JordonLong/Team03-TelemetryModule/README.md

# Team03-TelemetryModule
ELEC5551 Design Group 3 Telemetry Module Files

Please find the design outputs folder in this repository for UWA ELEC5551 Team03's telemetry System design
