JordonLong/Team03-TelemetryModule/06. Design Outputs/03. Documents/Team03 - Power Budget - V1 - 20240330.xlsx

Power-saving mode
 | Hour |  |  |  |  |  |  |  |  |  |  |  |  |  |  |  |  |  |  |  |  |  |  |  | RF Module Current Specification
 | 1 | 2 | 3 | 4 | 5 | 6 | 7 | 8 | 9 | 10 | 11 | 12 | 13 | 14 | 15 | 16 | 17 | 18 | 19 | 20 | 21 | 22 | 23 | 24
Component |  |  |  |  |  |  |  |  |  |  |  |  |  |  |  |  |  |  |  |  |  |  |  |  | Transmit current (mA) | 215
GPS | 25.00 | 0.42 | 0.42 | 0.42 | 0.42 | 0.42 | 0.42 | 0.42 | 0.42 | 0.42 | 0.42 | 0.42 | 0.42 | 0.42 | 0.42 | 0.42 | 0.42 | 0.42 | 0.42 | 0.42 | 0.42 | 0.42 | 0.42 | 0.42 | Sleep mode current (mA) | 0.0025
RF Module | 109.29 | 3.59 | 3.59 | 3.59 | 3.59 | 3.59 | 3.59 | 3.59 | 3.59 | 3.59 | 3.59 | 3.59 | 3.59 | 3.59 | 3.59 | 3.59 | 3.59 | 3.59 | 3.59 | 3.59 | 3.59 | 3.59 | 3.59 | 3.59 | Sleep time (second) | 59
Microcontroller | 0.02 | 0.02 | 0.02 | 0.02 | 0.02 | 0.02 | 0.02 | 0.02 | 0.02 | 0.02 | 0.02 | 0.02 | 0.02 | 0.02 | 0.02 | 0.02 | 0.02 | 0.02 | 0.02 | 0.02 | 0.02 | 0.02 | 0.02 | 0.02 | Wake time (second) | 1
Internal ICs of PSU | 20.00 | 20.00 | 20.00 | 20.00 | 20.00 | 20.00 | 20.00 | 20.00 | 20.00 | 20.00 | 20.00 | 20.00 | 20.00 | 20.00 | 20.00 | 20.00 | 20.00 | 20.00 | 20.00 | 20.00 | 20.00 | 20.00 | 20.00 | 20.00
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
