JordonLong/Team03-TelemetryModule/06. Design Outputs/01. Altium Files/00. Payload Transceiver/00. Main PCB Files/Report Board Stack/TelemetrySystem.xls

Board Stack Report
Stack Up |  | Layer Stack
Layer | Board Layer Stack | Name | Material | Thickness | Constant
1 |  | Top Paste
2 |  | Top Overlay
3 |  | Top Solder | Solder Resist | 0.010mm | 3.5
4 |  | Top Layer | Copper | 0.036mm
5 |  | Dielectric 6 | PP-006 | 0.071mm | 4.1
6 |  | +3.3V Plane | Copper | 0.035mm
7 |  | Dielectric 1 | FR-4 | 0.320mm | 4.8
8 |  | EW2 | Copper | 0.035mm
9 |  | Dielectric 4 | PP-006 | 0.071mm | 4.1
10 |  | +1.2V Plane | Copper | 0.035mm
11 |  | Dielectric 2 | PP-006 | 0.071mm | 4.1
12 |  | GND Plane | Copper | 0.035mm
13 |  | Dielectric 3 | PP-006 | 0.071mm | 4.1
14 |  | EW1 | Copper | 0.035mm
15 |  | Dielectric 5 | PP-006 | 0.071mm | 4.1
16 |  | Bottom Layer | Copper | 0.036mm
17 |  | Bottom Solder | Solder Resist | 0.010mm | 3.5
18 |  | Bottom Overlay
19 |  | Bottom Paste
 | Height : 0.942mm
