JordonLong/Team03-TelemetryModule/06. Design Outputs/01. Altium Files/01. Base Station Transceiver/01. Base Station Manufacturing Files/Report Board Stack/BaseStation.xls

Board Stack Report
Stack Up |  | Layer Stack
Layer | Board Layer Stack | Name | Material | Thickness | Constant
1 |  | Top Paste
2 |  | Top Overlay
3 |  | Top Solder | Solder Resist | 0.40mil | 3.5
4 |  | Top Layer | Copper | 1.40mil
5 |  | Dielectric 2 | PP-006 | 2.80mil | 4.1
6 |  | Ground | Copper | 1.38mil
7 |  | Dielectric 1 | FR-4 | 12.60mil | 4.8
8 |  | Bottom Layer | Copper | 1.40mil
9 |  | Bottom Solder | Solder Resist | 0.40mil | 3.5
10 |  | Bottom Overlay
11 |  | Bottom Paste
 | Height : 20.38mil
