JordonLong/Team03-TelemetryModule/06. Design Outputs/03. Documents/Team03 - NTC Temperature Sensor Conversion Graph - V1 - 20240514.xlsx

Constants |  |  | T ( Kelvin) | T (ºC) | Steinhart-Hart Equation (Ω)
 |  |  | 253.15 | -20 | 84.271
R0 (Ω) | β at 25ºC | T0 (Kelvin) | 257.15 | -16 | 67.651
10000 | 3575 | 298.15 | 261.15 | -12 | 54.676
 |  |  | 265.15 | -8 | 44.474
 |  |  | 269.15 | -4 | 36.399
 |  |  | 273.15 | 0 | 29.965
 |  |  | 277.15 | 4 | 24.807
 |  |  | 281.15 | 8 | 20.648
 |  |  | 285.15 | 12 | 17.275
 |  |  | 289.15 | 16 | 14.524
 |  |  | 293.15 | 20 | 12.269
 |  |  | 297.15 | 24 | 10.412
 |  |  | 301.15 | 28 | 8.874
 |  |  | 305.15 | 32 | 7.595
 |  |  | 309.15 | 36 | 6.527
 |  |  | 313.15 | 40 | 5.631
 |  |  | 317.15 | 44 | 4.876
 |  |  | 321.15 | 48 | 4.237
 |  |  | 325.15 | 52 | 3.695
 |  |  | 329.15 | 56 | 3.233
 |  |  | 333.15 | 60 | 2.837
 |  |  | 337.15 | 64 | 2.498
 |  |  | 341.15 | 68 | 2.206
 |  |  | 345.15 | 72 | 1.954
 |  |  | 349.15 | 76 | 1.735
 |  |  | 353.15 | 80 | 1.545
 |  |  | 357.15 | 84 | 1.380
 |  |  | 361.15 | 88 | 1.235
 |  |  | 365.15 | 92 | 1.108
 |  |  | 369.15 | 96 | 0.996
