JordonLong/Team03-TelemetryModule/06. Design Outputs/03. Documents/Team_3 Requirements Review.xlsx

ID | Requirement Title | Requirement description | Test | Passed | Learnings
RQ1 | Protection system | Suitable voltage regulators/converters need to be used to supply stable and correct voltages to individual components/subassemblies. | Simulations were conducted on both Simulink and LT Spice to validate the effectiveness of the design. Power simulations were conducted for the GPS, XBee and boost converter modules. | YES | The client was not specific about load requirements, giving the project team flexibility in how to approach the issue. Simulations provided a fundamental understanding of how the system will respond under both transient and steady state conditions.
RQ2 | Compliance | Quality components are compliance tested according to suitable standards or certificates identified by Team03. | All components were sourced through established licensed suppliers who conduct product testing. More so, each component was chosen only if its datasheet specified conditions such as RoHS compliance. | YES | Choosing components from professional vendors saves a significant amount of time compared to choosing un-professional vendors whose products require re-choosing more often.
RQ3 | Unlicensed frequency | Transmitters/receivers must use unlicensed frequency as part of the Low Interference Potential Devices (LIPD) class license. This entails operating within a range of frequencies, at maximum power and complying with other limitations stated in the license class. | The chosen XBee and GPS modules do not require the use of licensed frequencies. XBee module maximum power is below the allowable limit. | YES | There are a considerable number of Australian standards and laws related to operating radio equipment. Adhering to these laws and standards is essential for a legal and safe radio-based system.
RQ4 | Temperature | Telemetry system’s maximum operating temperature must be above 60°C. | All individual components were selected under the condition that their maximum operating temperature was above 60°C. Thermal testing was also conducted under various conditions to validate the design solution. | YES | The thermal simulation revealed that components approach their maximum operating temperature much more quickly than anticipated and thus require maximum operating temperatures to be as high as possible.
RQ5 | Thermal management | Provide heat dissipating mechanisms and select energy-efficient devices that minimise lost energy due to heat. | A thermal simulation was performed to evaluate the effectiveness of the designed payload transceiver PCB regarding thermal management. Considerations such as PCB thickness, component placement, power dissipation and maximum operating temperature were considered. | YES | Placement of components which generate significant heat must be separated. Smaller components with higher current draws often emit the most thermal energy.
RQ6 | Telemetry logging | Continuous interface with the drone’s sensors, logging telemetry data which can be later easily reviewed and downloaded. | RS232 and RS485 compatible ports have been included and connected to the payload transceiver such that their data can be stored on the onboard micro-SD card or transmitted via the radio module. | YES | Communications protocols often require more than simply connecting the ports to GPIOs of the microcontroller. They may have specific voltage level requirements and even work with negative voltages. Thus, additional components such as dedicated transceivers are necessary to ensure optimal communications.
RQ7 | Battery management system | The power supply will have battery health monitoring capability. The power supply will have battery charging capability. | Temperature monitoring sensors have been integrated into the design along with a fuel gauge to track the battery’s health. | YES | Temperature sensors come in several different types and choosing a particular model requires knowledge of the expected operating conditions and a compromise between accuracy and robustness.
RQ8 | Triangulation | Module needs to have radio triangulation capability that works if GPS hits a dead zone or activated for recovery upon landing. | Both triangulation and trilateration were implemented in conjunction with 3 base stations to ensure efficient tracking capabilities. | YES | Clear communication ensured that team 3 and the client were on the same page. In order to implement radio triangulation within the final design. Incorporating three base stations ensured this project requirement is achieved.
RQ9 | Sensor integration | The chosen microcontroller must have the ability to interact with RS232 and RS485 ports . | Any microcontroller with a UART port can interact with RS232 and RS485 ports provided that the necessary transceivers are implemented as well. | YES | Level shifters were required to integrate this as the RS232 and RS485 ports work in both negative and positive voltages, while the controller only functions on positive voltage. This required research into level shifters as well as the correct circuit connectivity and the appropriate component selection.
RQ10 | Data storage | The data for the whole flight should be stored in the memory. It can be cleared after recovery. | An SD card was integrated with the microcontroller to ensure adequate backup data storage within the drone. All data was also transmitted to the base station during nominal flight conditions. Functional control of the system was developed through the pseudo code of the design. | YES | The importance of redundancy features were clearly communicated by the client and incorporated into the design. This was achieved by selectively choosing components which are well established and proven. This methodology provides a reliable solution for the design’s redundancy features.
 |  | Remember the last few positions so that they can be re-transmitted if the previous packet get lost.
RQ11 | Long operation | Module needs to be able to run for at least 24 hours on standalone battery power | The batteries were appropriately sized based off an energy budget which analysed the energy consumption of the drone at all stages of operation | YES | Basing the energy consumption on the individual components while accounting for worst case energy usage ensuring that even under high loads the design can sustain operation for 24 hours. This in conjunction with redundancy features within the software to shutdown accessory loads ensure the payload can be located.
RQ12 | Control Unit | The microcontroller will be 32bit at the minimum . | Chosen microcontroller STM32u545 is 32 bits. | YES | Controllers with smaller bus lengths were incapable of providing the necessary processing power and high performance.
RQ13 | GPS accuracy | Module needs to have GPS tracking capability with at least <3m accuracy in three dimensions. | The GPS module is accurate to 2.5m according to the datasheet. However, based on triangulation calculations the altitude measurement has a margin of error of | NO | The GPS can provide accuracy levels for its longitude and latitude to the required specifications based off the datasheet. However, team 3 and the client were conflicted about the possible error margin for altitude calculations, further discussions may be required. Especially given the speed and altitude of the rocket. Making this requirement a significant challenge.
 |  |  | 4.592m.
RQ14 | Communication range | Telemetry transceiver must be able to transmit within 10km radius. | The telemetry module uses a monopole antenna with sufficient gain required by XBee datasheet (Table 10) to achieve operating range over 10km. | YES | Lack of prebuilt XBee models in the literature to simulate the transmitter, channel and receiver. Operating range is confirmed via product datasheet, however, verification could not be achieved without physical components.
RQ15 | Data transmission | Transmission rate must be at least 5kbit/s. | The chosen radio communication module can provide 10kbits/s data rate according to Table 10. | YES | Similar to RQ14, due to the lack of simulation resources, requirement could not be physically verified. However, datasheet indicates twice the required data rate which provides safe clearance from the minimum rate.
 |  | PCBs will be designed for high-speed operation and strong signal integrity .
RQ16 | Radio triangulation accuracy | Can be activated within 10-20m and omnidirectional . | Using information from the antenna and radio module datasheets it was summised that the telemetry system can achieve a 10m-20m activation from any direction. | YES | The monopole antenna is omnidirectional as specified by its datasheet, thus allowing for radio communications to be sent and received from any direction. To achieve 10m-20m activation, the specific Xbee radio module was chosen such that it has a variable transmission range down to at least 10m if required.
RQ17 | Redundancy | Module must have built in redundancy to ensure continuous operation in the event of failures in internal / interconnected systems. | The GPS module and SD card have inbuild data storage. The code also has inbuild failsafe methods to ensure the drone can operate independently. When communication from the base station fails | YES | Redundancy features were implemented through a multi-layered data storage which can act independently from each other during emergencies. By relying on multiple components with different functions such as the Base station, GPS and SD card. The design can ensure flight data can be recovered.
RQ18 | Robust to withstand impact | Each individual component should be rated to withstand at least 8m/s impact. | No specific tests were applied due to the lack of proper impact simulation software. Additionally, no datasheets of individual components offered any impact ratings / data. | NO | The acquisition of dedicated stress / impact testing software would be beneficial in providing the client with a specific estimate of the telemetry system’s impact resistance.
RQ19 | User-interface | Develop a limited user interface for the base station's operation. | UI was developed and visualized to provide key telemetry data which requested by the client during flight. | YES | The importance of selecting a component that has an existing proprietary user interface alongside a dedicated test and configuration suite. This allows for robust configuration of parameters and testing through a dedicated software suite. The client had no requirement for a custom interface and was satisfied with a proprietary manufacture interface.
RQ20 | Mounting | PCBs must provide adequate mounting points (with clearance) to ensure easy installation within the payload. | Four M3 mounting holes have been incorporated into each corner of the payload transceiver PCB. | YES | PCB hole mounts are placed based on the recommended guidelines for PCB design. This guideline provides a reliable method to ensure the PCB remains fixed within the payload.
RQ21 | Small | Module needs to fit within a 1U cube-sat payload alongside all other components. The module itself can take up a maximum of 80mm (L) x 80mm (W) x 20mm (H) | The size of the PCB during the design was heavily regulated to ensure it meets this requirement | YES | The client was clear about the size restrictions of the design as it needed to fit within the 1U payload. This ensured the PCB design was within the required physical dimensions.
RQ22 | Light weight | Module needs to be lightweight (5 - 50g), however, if between 50-100g the design group should explain why and keep the weight low | The total weight of the design was tracked by recording the weight of each individual component. The final design weight is 73.25 grams. | YES | Initially the client underestimated the weight of the component. By communicating that the batteries would need to be sized to meet 24hr lifespan, a module between 50-100g was agreed upon. Relying on the datasheets for each individual component ensured that accurate weight measurements were able to be recorded.
RQ23 | Open-source software/hardware | Simulation, control system, communication system, etc. should be prepared using open-source licensed software. | Python and Circuit Maker were selected for PCB design and coding as they are free to use resources. | NO | Fusion 360, Altium circuit maker and PICLS Lite, Fusion 360 were used. These are not open source, but they are free. These were specifically chosen due to the robustness and analysis capability of the software, alongside prior experience working with them. This allowed for the expedited development of the PCB and a reduction of the learning curve needed to familiarize with a different development platform that is open so.
 |  | Hardware should be designed using an open-hardware license (CERN-OHL-P)
RQ24 | Expandability | There will be space in either hardware or software for future functionality expansion. | Choosing design components such as the GPS which are reconfigurable allow for significant flexibility in required data packages and functionality. | YES | The expandability of the design is based on the ability to configure the individual components through the software. Allowing for alternative data packets or information to be transmitted from the drone. By utilizing modules which have this technology, it ensures an established and reliable model is being implemented.
RQ25 | Additional triangulation | Continuous triangulation during flight to track drone's trajectory | A GPS module along with triangulation and trilateration have been implemented to allow for accurate tracking of the drone. | YES | This aspect of the report is unable to be tested at this stage of the design. Previous projects along with datasheets provided the foundational information to track the payload. This methodology has been well established and specified as a desired feature by the client.
RQ26 | Base-station | Base station receivers should be low-powered and handheld | The Base station is designed to be USB compatible for ease of integration with laptops. Base station PCB is 230mmx130mm (width x length) | YES | The user-friendly nature of the base station was communicated by the client as a key feature within the design. Incorporating an easy-to-use USB technology ensures that there is a minimal learning curve while also utilized well established technology to provide power and track telemetry data.
