JordonLong/Team03-TelemetryModule/06. Design Outputs/02. Base Station Enclosure/01. 3D Model STL files/Base Station Enclosure Assembly.stl

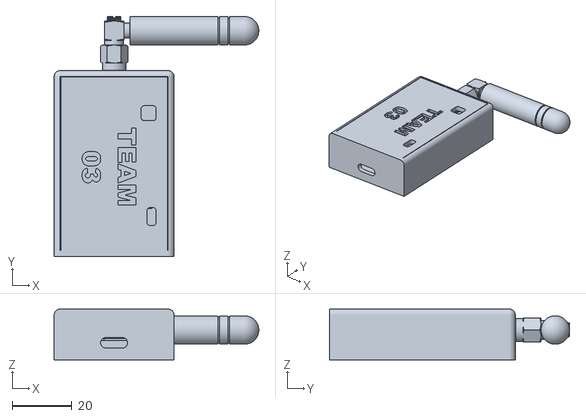
[picture p1: CAD file, 2024-05-27]
06. Design Outputs/02. Base Station Enclosure/01. 3D Model STL files/Base Station Enclosure Assembly.stl
68.3 x 80.1 x 17.0
