JordonLong/Team03-TelemetryModule/06. Design Outputs/02. Base Station Enclosure/01. 3D Model STL files/Base Station Enclosure - V15.stl

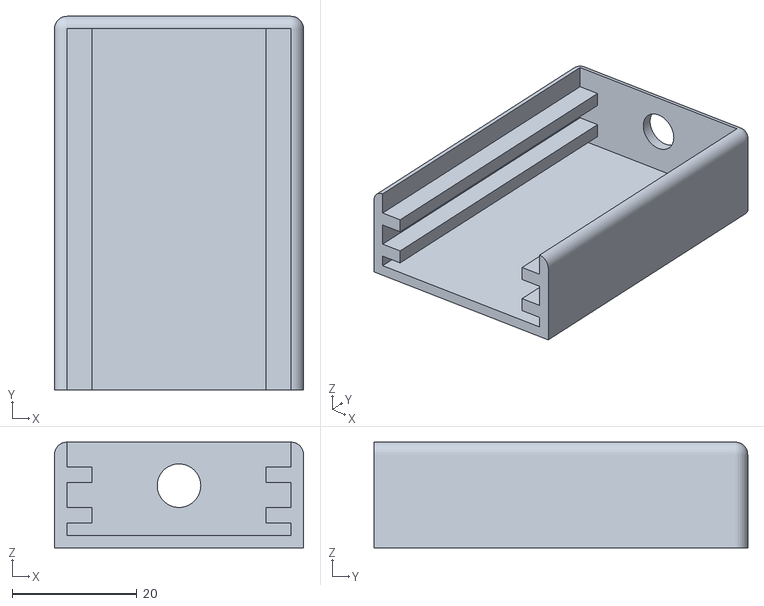
[picture p2: CAD file, 2024-05-27]
06. Design Outputs/02. Base Station Enclosure/01. 3D Model STL files/Base Station Enclosure - V15.stl
40.0 x 60.0 x 17.0
