JordonLong/Team03-TelemetryModule/06. Design Outputs/02. Base Station Enclosure/01. 3D Model STL files/Base Station Enclosure LId - V25.stl

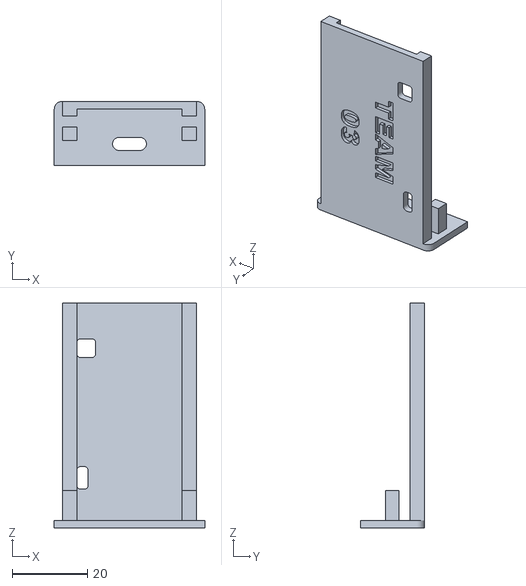
[picture p3: CAD file, 2024-05-27]
06. Design Outputs/02. Base Station Enclosure/01. 3D Model STL files/Base Station Enclosure LId - V25.stl
40.0 x 17.0 x 59.8
