JordonLong/Team03-TelemetryModule/(list of files, cad)

Other CAD files:
06. Design Outputs/02. Base Station Enclosure/00. Fusion 360 Files/Base Station Enclosure - V15.f3d
06. Design Outputs/02. Base Station Enclosure/00. Fusion 360 Files/Base Station Enclosure Assembly.f3z
06. Design Outputs/02. Base Station Enclosure/00. Fusion 360 Files/Base Station Enclosure LId - V25.f3d
