JordonLong/Team03-TelemetryModule/06. Design Outputs/01. Altium Files/01. Base Station Transceiver/00. Base Station Assembly Files/Assembly.PDF

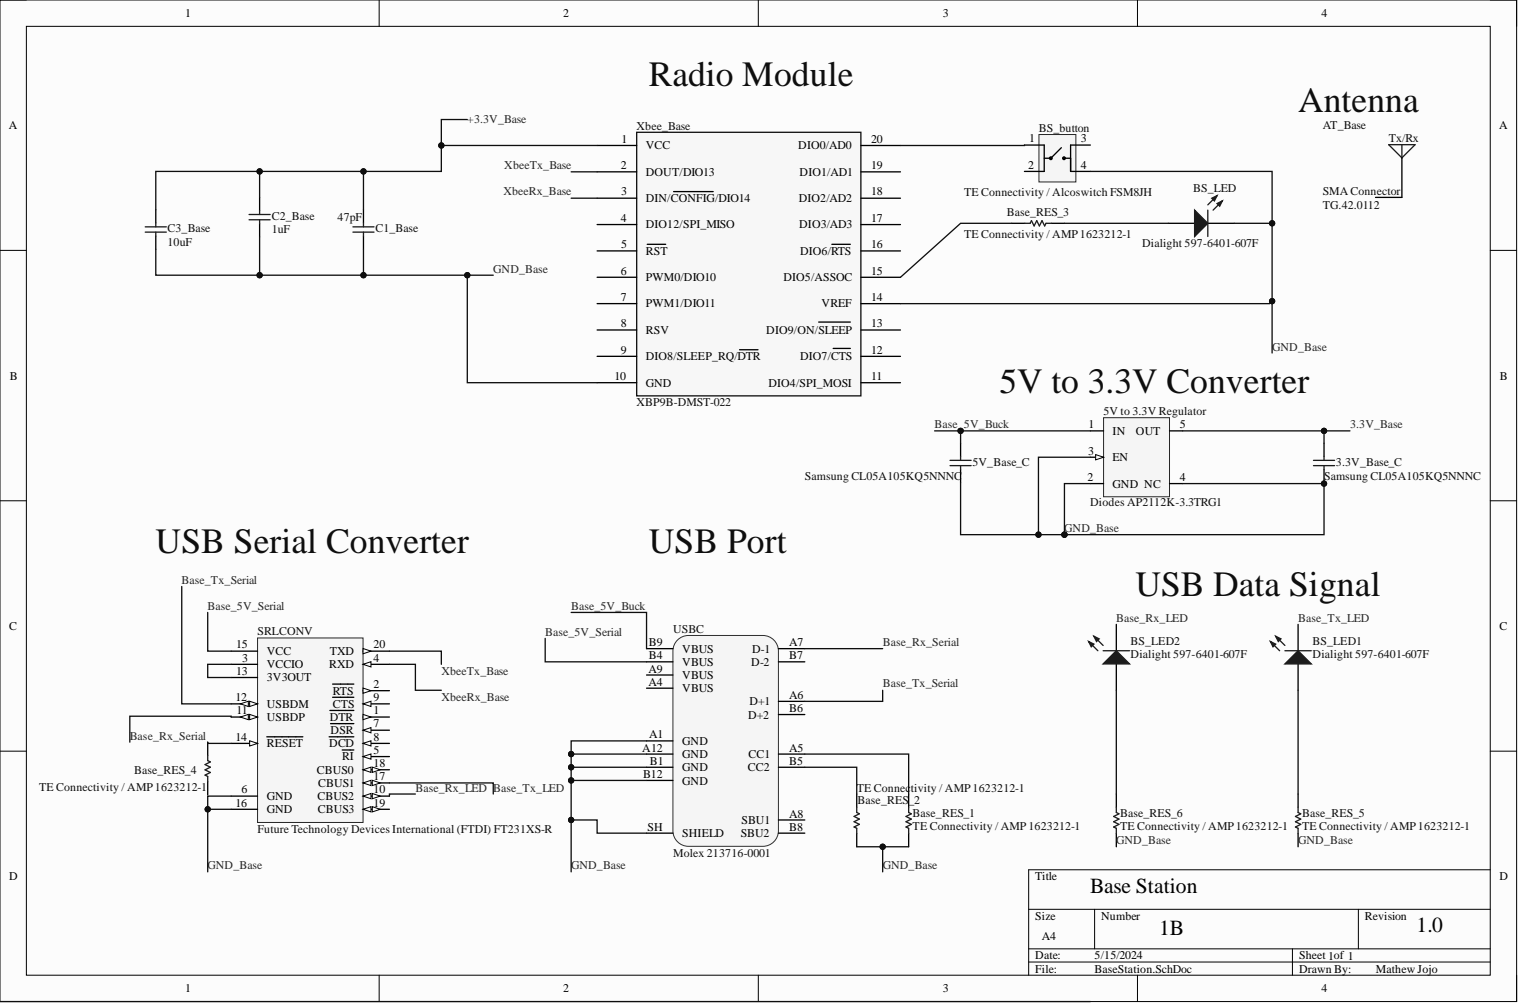
[picture p4: page 1]
Date:; Sheet of; File:; BaseStation.SchDoc; Drawn By:; VBUS B9; GND B12; VBUS B4; GND B1; GND A1; VBUS A4; VBUS A9; GND A12; SHIELD SH; Molex 213716-0001; USB Serial Converter; USB Port; VCC 15 VCCIO 3 3V3OUT 13; USBDM 12 USBDP 11; RESET 14; GND 6; CBUS3; 19 CBUS2; 10 CBUS1; 17 CBUS0; 5 DCD; 8 DSR; 7 DTR; 1 CTS; 9 RTS; Mathew Jojo; Base Station; Radio Module; Dialight 597-6401-607F; C1_Base 47pF; 5V to 3.3V Converter; GND 2; 5V to 3.3V Regulator; Diodes AP2112K-3.3TRG1; Samsung CL05A105KQ5NNNC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

TE Connectivity / Alcoswitch FSM8JH

TE Connectivity / AMP 1623212-1

GND_Base
USB Data Signal

Base_Rx_LED

Base_RES_2

GND 16

Base_RES_1

Base_RES_6

Base_RES_5

Future Technology DevicesInternational (FTDI) FT231XS-R

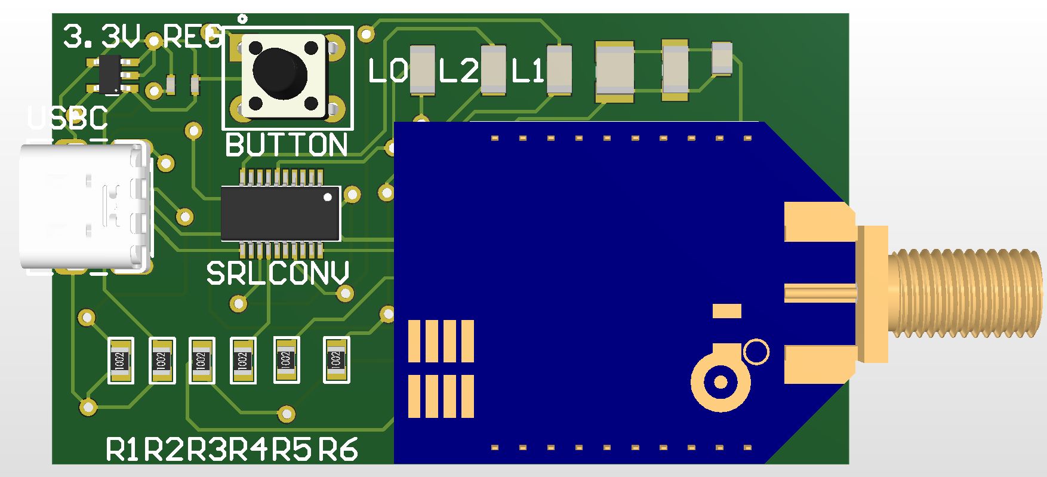
[picture p5: page 2]

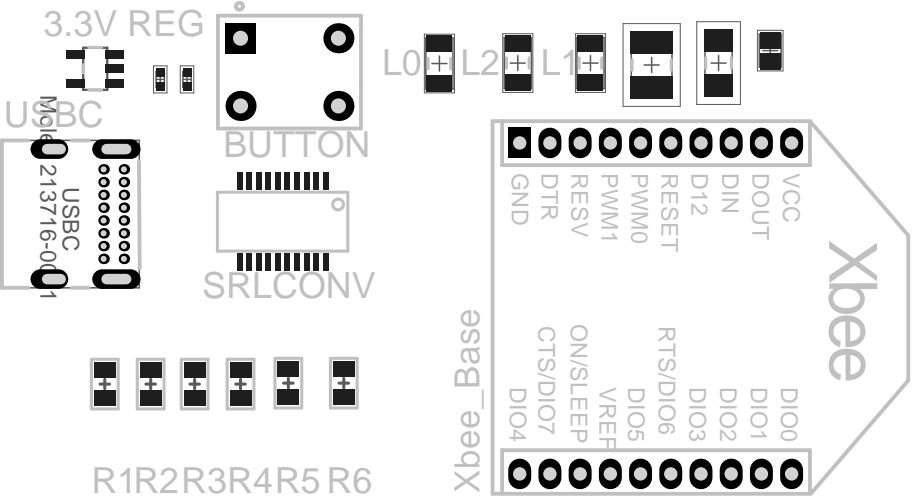
[picture p6: page 4]

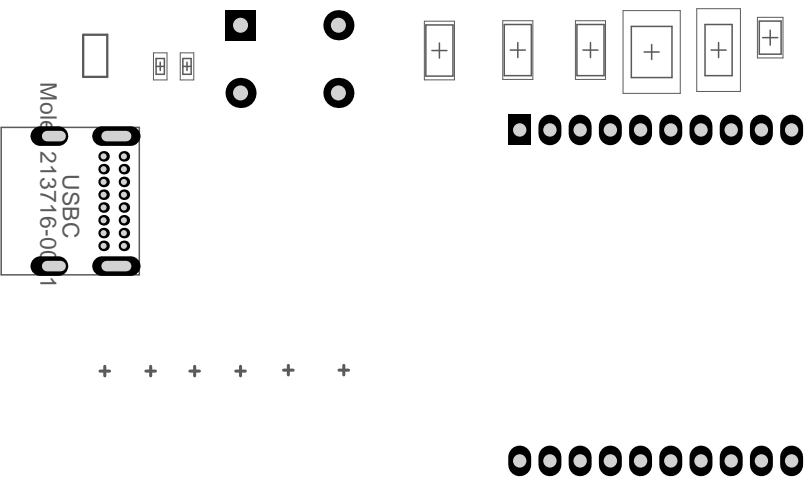
[picture p7: page 5]

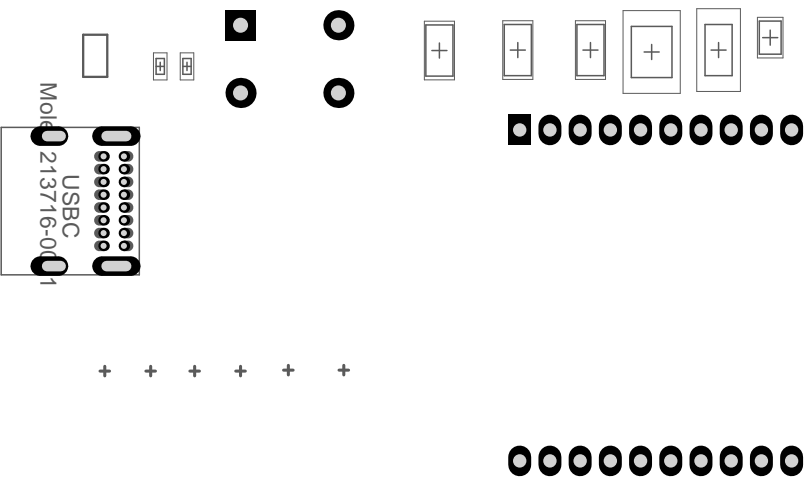
[picture p8: page 6]
