JordonLong/Team03-TelemetryModule/06. Design Outputs/04. Simulations/ThermalSimOutputs.pdf

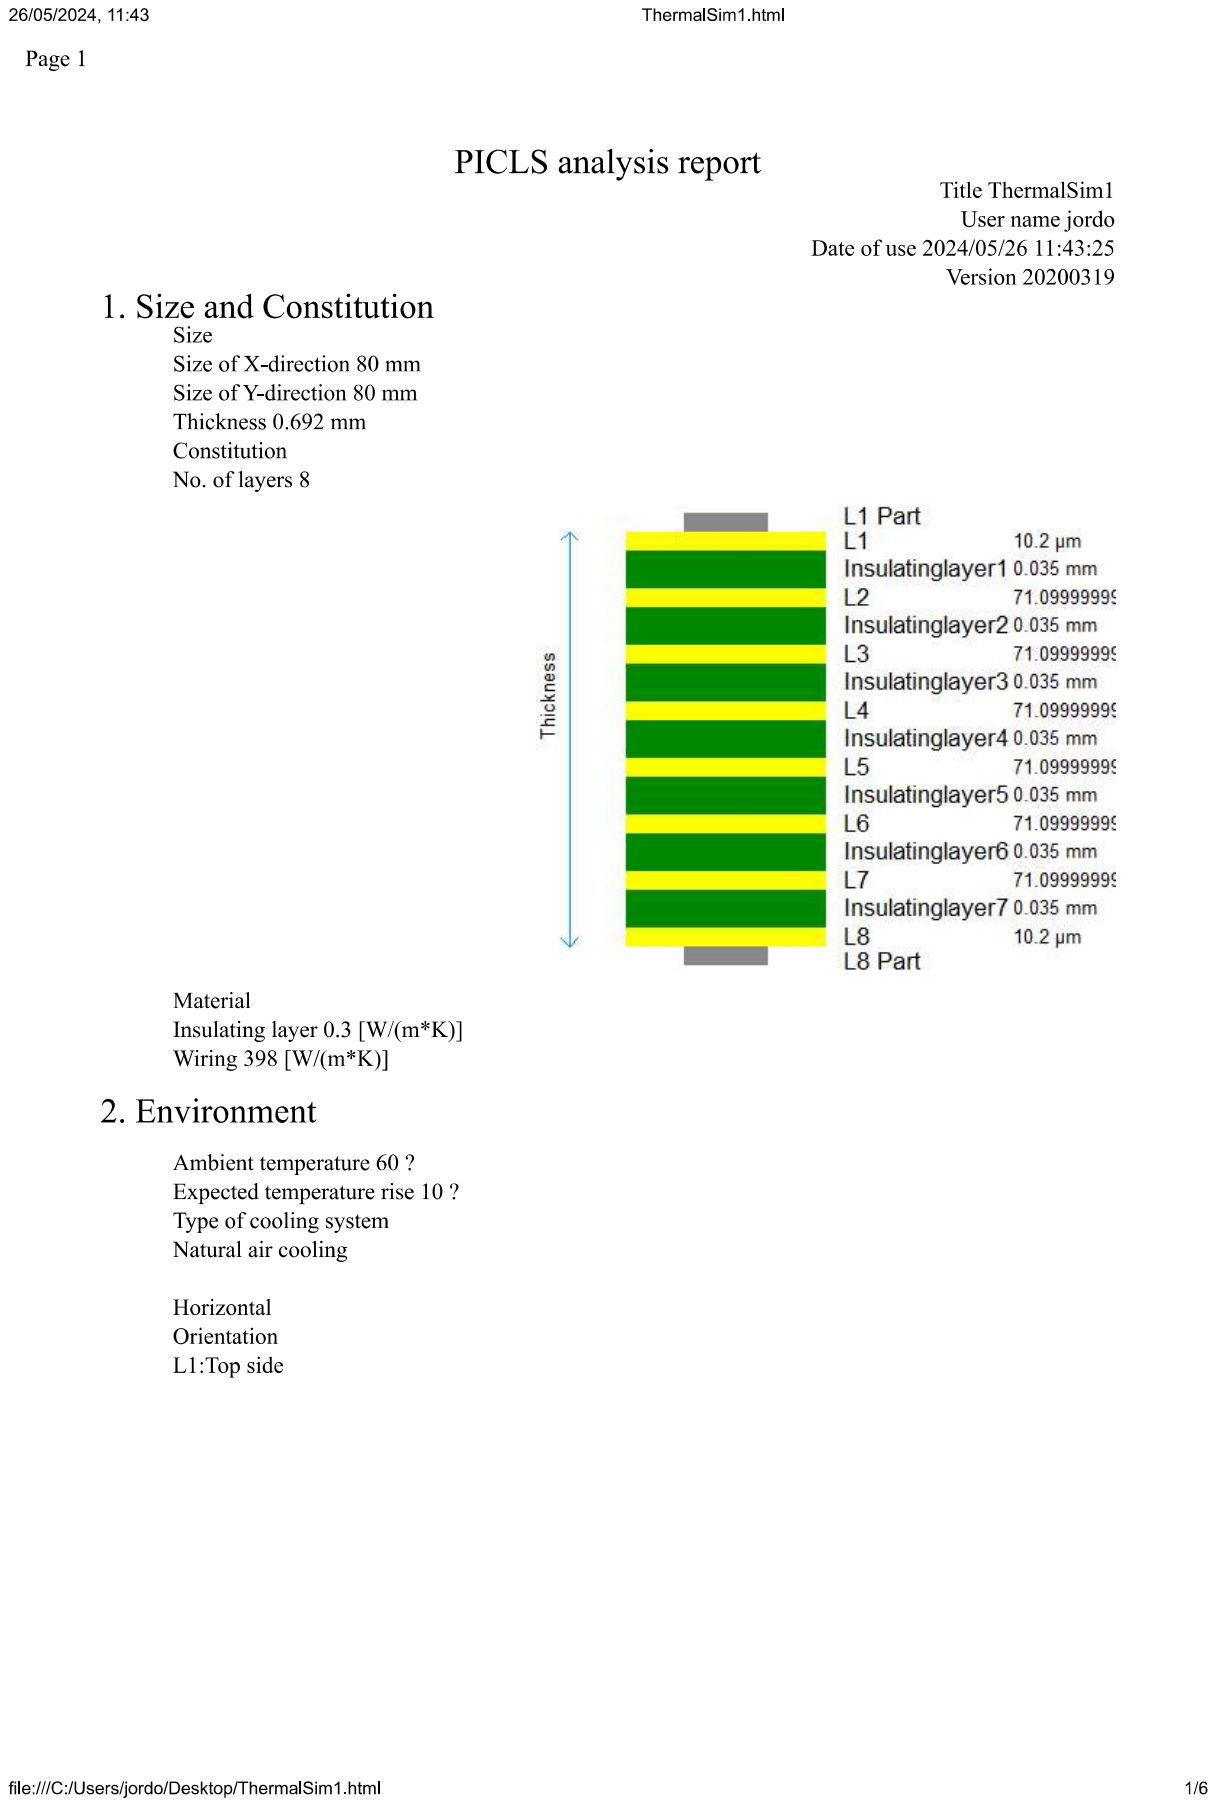
[picture p9: page 1]

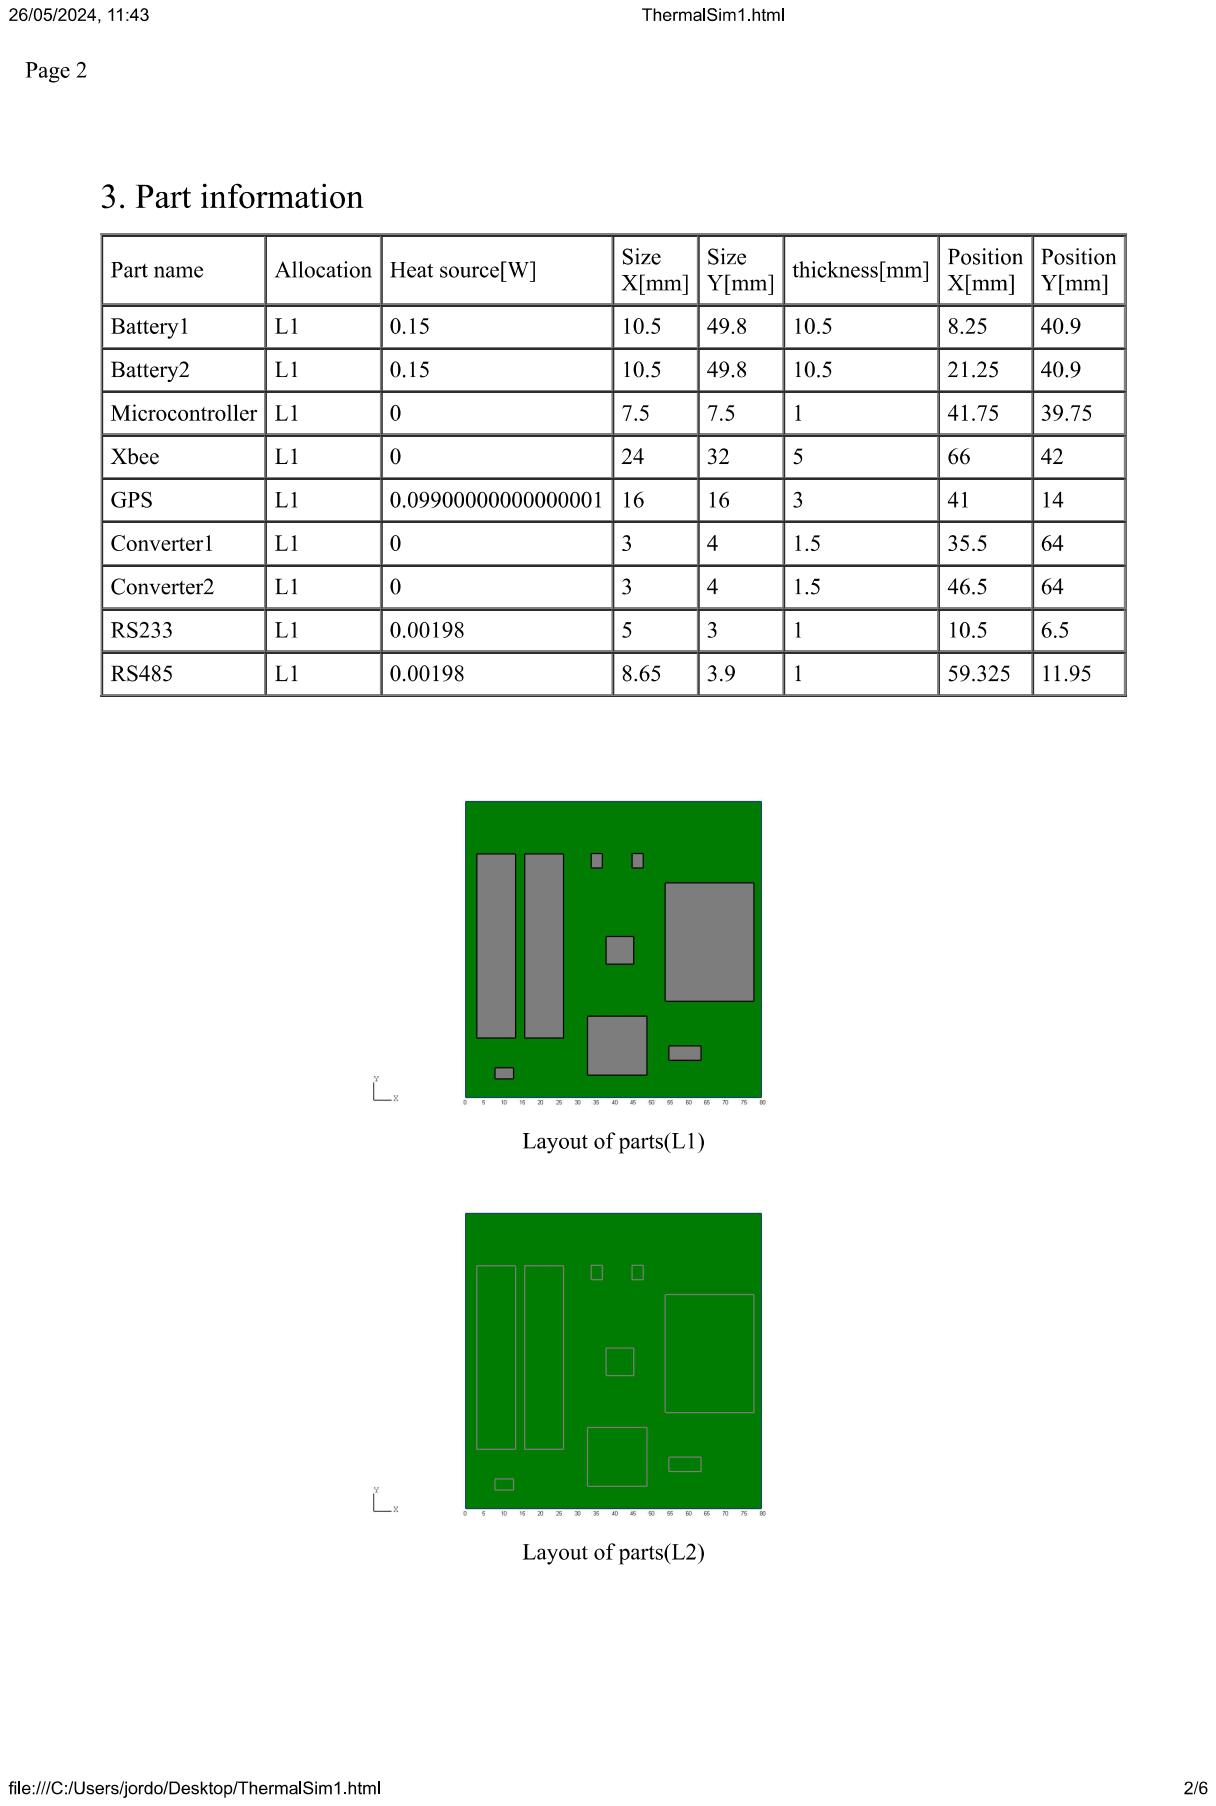
[picture p10: page 2]

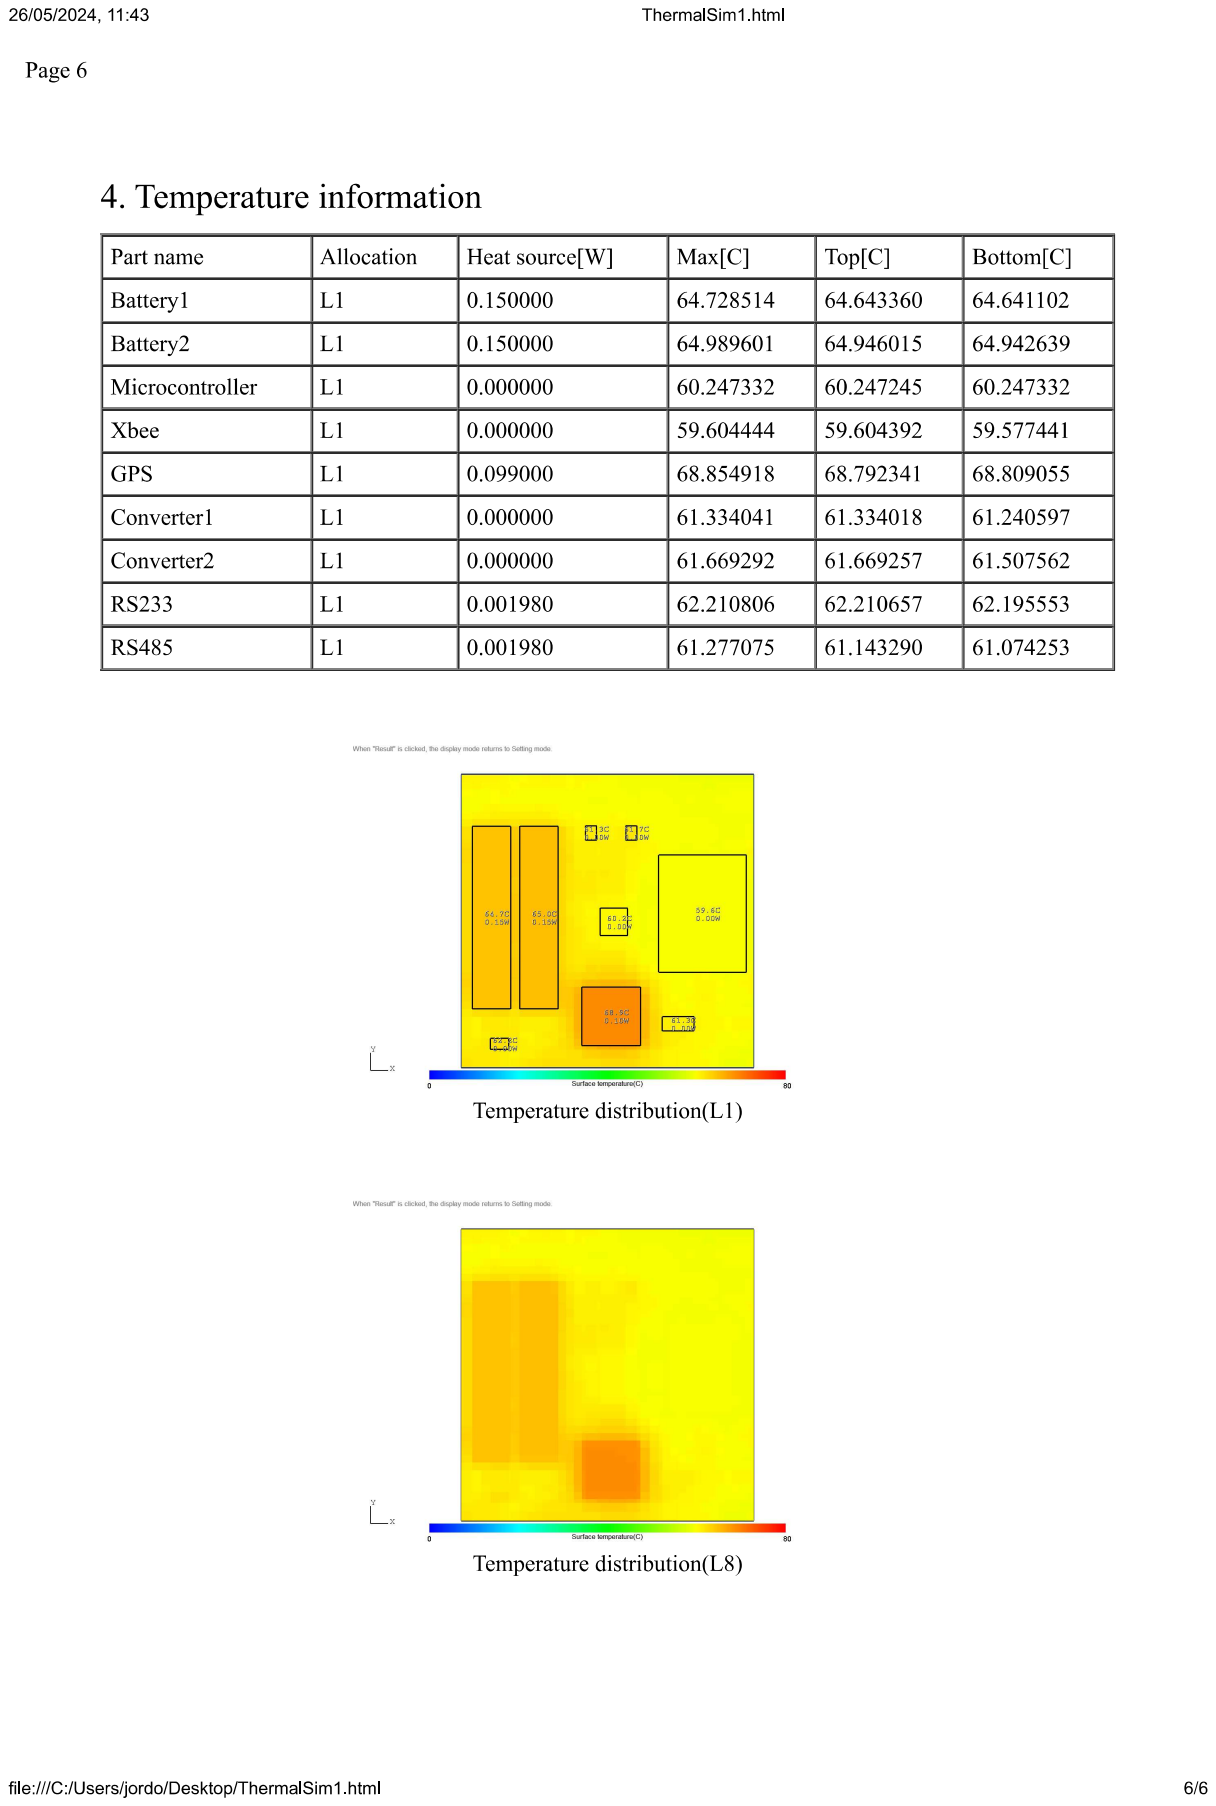
[picture p11: page 3]
