JordonLong/Team03-TelemetryModule/06. Design Outputs/01. Altium Files/00. Payload Transceiver/00. Main PCB Files/Fabrication.PDF

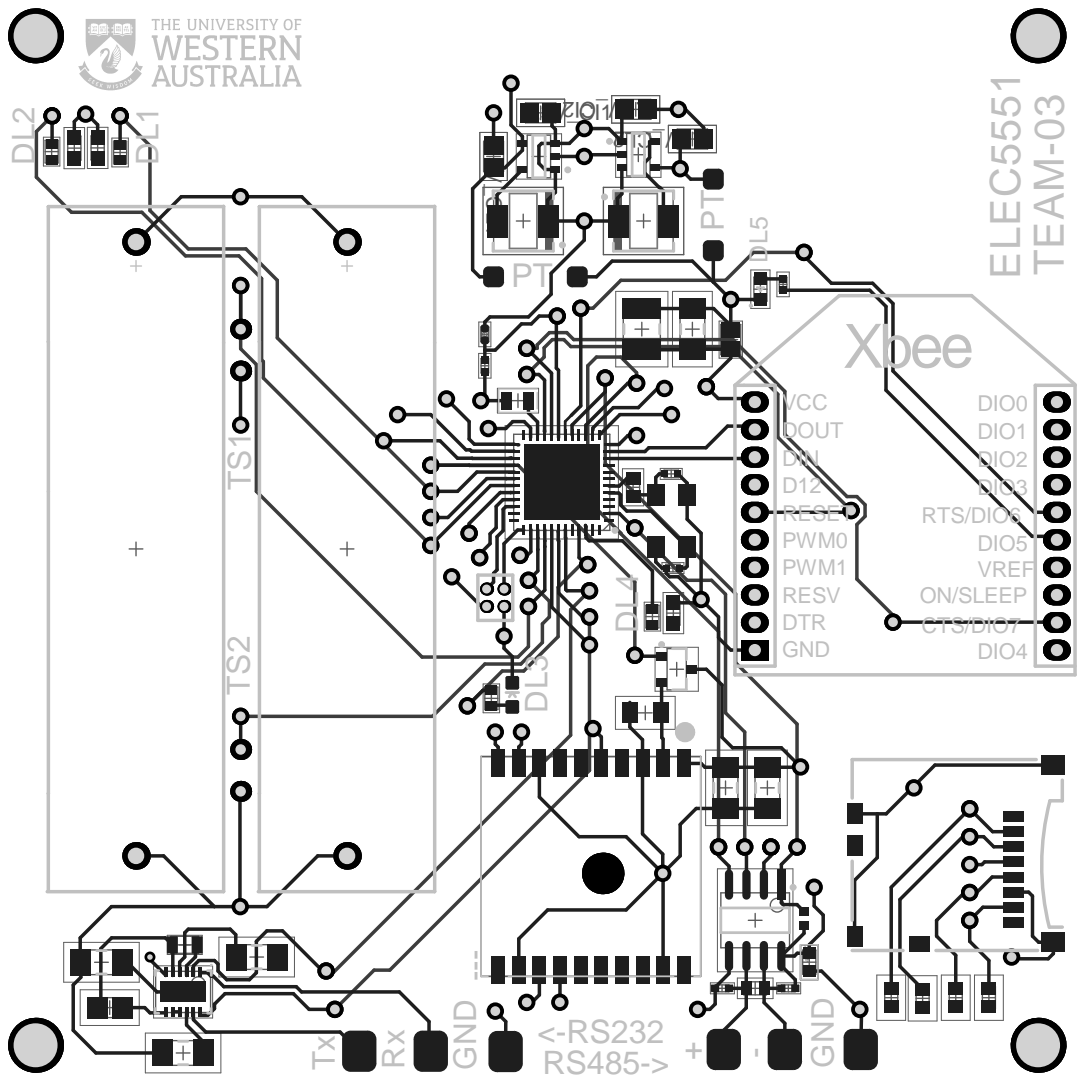
[picture p12: page 1]
