JordonLong/Team03-TelemetryModule/06. Design Outputs/01. Altium Files/01. Base Station Transceiver/01. Base Station Manufacturing Files/Fabrication.PDF

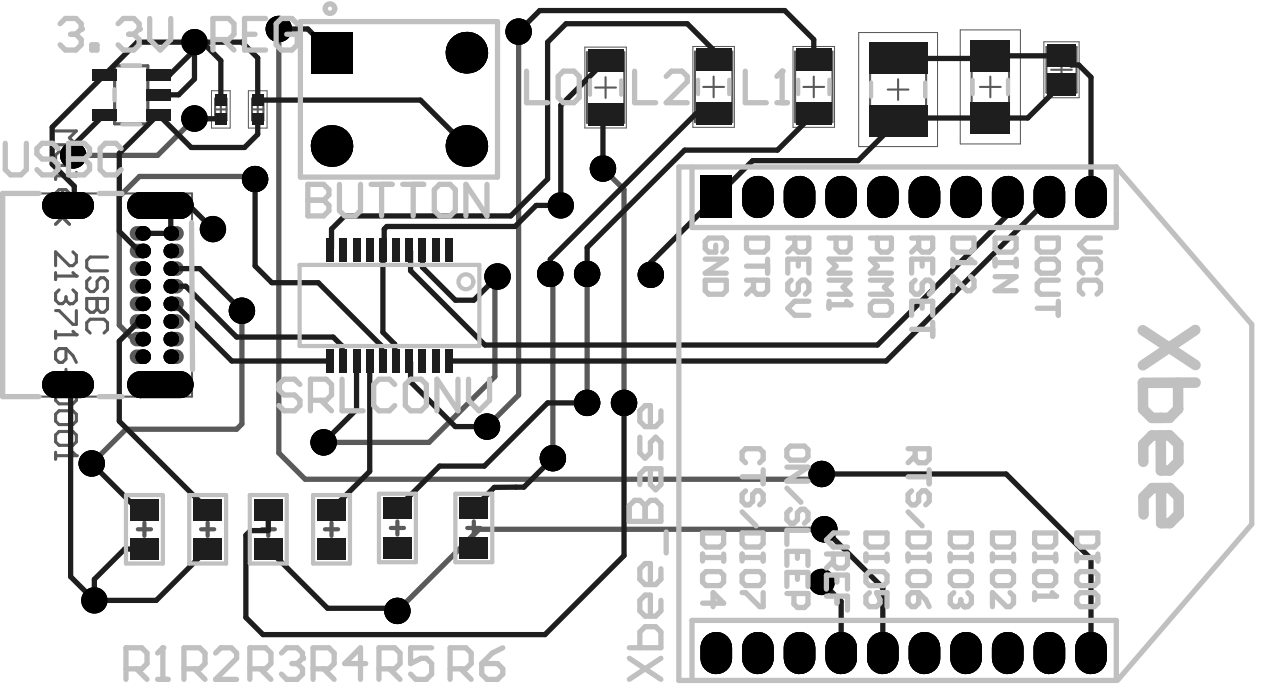
[picture p13: page 1]
