JordonLong/Team03-TelemetryModule/06. Design Outputs/04. Simulations/GPS_Power Supply Simulation.asc

C1: cap; 1µF
C2: cap; 10µF
D1: diode
L1: ind; 300µF
M1: nmos; Si7336ADP
R1: res; 165
V1: voltage; 1.3
V2: voltage; SINE(0 0.3 50); AC 0.3
V3: voltage; PULSE(0 30 0 0 0 0 0.000000001)
Named nets: 0
.tran 0 1 0
