JordonLong/Team03-TelemetryModule/06. Design Outputs/00. Code/main.py

import time
import serial

# Configure serial communication with the XBee module
ser = serial.Serial(
    port='/dev/ttyUSB0',  # Update this to your correct port (e.g., COM3 on Windows)
    baudrate=9600,        # Match this with the baud rate set in XCTU
    timeout=1
)

# Functions for serial communication with XBee
# Xbee has propietary console to initiate this please look at XCTU manual

def send_data_to_xbee(data):
    ser.write(data.encode())
    print(f"Sent: {data}")

def read_data_from_xbee():
    data = ser.read(ser.in_waiting or 1).decode()
    if data:
        print(f"Received: {data}")
    return data

# Battery Monitoring Subroutine
# Calling Battery monitoring suboutines that pertain to fuel gauge and battery temperature
def monitor_battery_status():
    send_data_to_xbee('Monitor Battery Status')
    response = read_data_from_xbee()
    print(f"Battery Status: {response}")

def check_charge_levels():
    send_data_to_xbee('Check Charge Levels')
    response = read_data_from_xbee()
    print(f"Charge Levels: {response}")
    return response == "OK"  # Simulated check

def transmit_battery_status():
    send_data_to_xbee('Transmit Battery Status')
    response = read_data_from_xbee()
    print(f"Battery Status Transmitted: {response}")

# Telemetry Subroutine
# Sleep Co-ordinator and telemetry parameters are configuration
def initialize_telemetry():
    send_data_to_xbee('Initialize Telemetry')
    response = read_data_from_xbee()
    print(f"Telemetry Initialization: {response}")

def sleep_coordinator():
    send_data_to_xbee('Sleep Coordinator')
    response = read_data_from_xbee()
    print(f"Sleep Coordinator: {response}")

def triangulation_and_tdoa():
    send_data_to_xbee('Triangulation and TDOA')
    response = read_data_from_xbee()
    print(f"Triangulation and TDOA: {response}")

# GPS Configuration Subroutine
def configure_output_packet():
    pmtk_command = "$PMTK314,1,1,1,1,1,5,0,0,0,0,0,0,0,0,0,0,0,0,0*2C<CR><LF>"
    ser.write(pmtk_command.encode())
    print("PMTK command sent to GPS module")

def initialize_gps():
    send_data_to_xbee('Initialize GPS')
    response = read_data_from_xbee()
    print(f"GPS Initialization: {response}")

def acquire_gps_data():
    send_data_to_xbee('Acquire GPS Data')
    response = read_data_from_xbee()
    print(f"GPS Data Acquired: {response}")

def transmit_gps_data():
    send_data_to_xbee('Transmit GPS Data')
    response = read_data_from_xbee()
    print(f"GPS Data Transmitted: {response}")

# Security Subroutine
def check_system_security():
    send_data_to_xbee('Check System Security')
    response = read_data_from_xbee()
    print(f"System Security Check: {response}")

def update_security_measures():
    send_data_to_xbee('Update Security Measures')
    response = read_data_from_xbee()
    print(f"Security Measures Updated: {response}")

def report_security_status():
    send_data_to_xbee('Report Security Status')
    response = read_data_from_xbee()
    print(f"Security Status Reported: {response}")

# Diagnostics Subroutine
def run_system_diagnostics():
    send_data_to_xbee('Run System Diagnostics')
    response = read_data_from_xbee()
    print(f"System Diagnostics: {response}")

def log_diagnostic_data():
    send_data_to_xbee('Log Diagnostic Data')
    response = read_data_from_xbee()
    print(f"Diagnostic Data Logged: {response}")

def report_diagnostic_status():
    send_data_to_xbee('Report Diagnostic Status')
    response = read_data_from_xbee()
    print(f"Diagnostic Status Reported: {response}")

# Function to commence test on landing
def commence_test_on_landing():
    send_data_to_xbee('Commence Test on Landing')
    response = read_data_from_xbee()
    print(f"Test on Landing: {response}")

# Function to check if component is working
def check_component():
    send_data_to_xbee('Check Component')
    response = read_data_from_xbee()
    print(f"Component Check: {response}")
    return response == "OK"  # Simulated return value

# Function to test GPIO pins every 5 minutes
def gpio_testing():
    send_data_to_xbee('Test GPIO Pins')
    response = read_data_from_xbee()
    print(f"GPIO Testing: {response}")
    time.sleep(GPIO_TEST_INTERVAL)

# Function to set GPIO pins to high
def set_gpio_pins_high():
    send_data_to_xbee('Set GPIO Pins High')
    response = read_data_from_xbee()
    print(f"GPIO Pins Set to High: {response}")

# Function to set GPIO pins to low
def set_gpio_pins_low():
    send_data_to_xbee('Set GPIO Pins Low')
    response = read_data_from_xbee()
    print(f"GPIO Pins Set to Low: {response}")

# Function to read GPIO status
def read_gpio():
    send_data_to_xbee('Read GPIO')
    response = read_data_from_xbee()
    print(f"GPIO Read: {response}")
    return response == "HIGH"  # Simulated return value

# Function to power off batteries
def power_off_batteries():
    send_data_to_xbee('Power Off Batteries')
    response = read_data_from_xbee()
    print(f"Batteries Powered Off: {response}")

# Function to switch to standby mode
def standby_mode():
    send_data_to_xbee('Switch to Standby Mode')
    response = read_data_from_xbee()
    print(f"Switched to Standby Mode: {response}")

# Function to execute emergency protocol
def emergency_protocol():
    send_data_to_xbee('Execute Emergency Protocol')
    response = read_data_from_xbee()
    print(f"Emergency Protocol Executed: {response}")

# Function to enable AES encryption
def enable_aes_encryption():
    send_data_to_xbee('Enable AES Encryption')
    response = read_data_from_xbee()
    print(f"AES Encryption Enabled: {response}")

# Function to check coordinates
def check_coordinates():
    send_data_to_xbee('Check Coordinates')
    response = read_data_from_xbee()
    print(f"Coordinates Checked: {response}")
    return response == "OK"  # Simulated return value

# Function to send data to base station
def send_to_base_station():
    send_data_to_xbee('Send Data to Base Station')
    response = read_data_from_xbee()
    print(f"Data Sent to Base Station: {response}")

# Initialize the system
def initialize_system():
    print("Initializing system...")

# Main function
def main():
    initialize_system()

    while True:
        monitor_battery_status()
        if check_charge_levels():
            transmit_battery_status()
        else:
            print("Battery level low. Operation halted.")
        
        initialize_telemetry()
        sleep_coordinator()
        triangulation_and_tdoa()

        run_system_diagnostics()
        log_diagnostic_data()
        report_diagnostic_status()

        check_system_security()
        update_security_measures()
        report_security_status()

        initialize_gps()
        acquire_gps_data()
        transmit_gps_data()

        # Wait for a specified interval before the next loop iteration
        time.sleep(60)  # Adjust the sleep duration as needed

# Execute main function
if __name__ == "__main__":
    main()
