JordonLong/Team03-TelemetryModule/06. Design Outputs/00. Code/Battery_temp.py

import time

# Constants
MAX_TEMP = 65.0
ADC_RESOLUTION = 1024
ADC_REFERENCE_VOLTAGE = 3.3

# Function prototypes
def initialize_gpio():
    # Initialize GPIO pins
    pass

def read_analog_value(pin):
    # Placeholder for reading analog value from a specified pin
    # Replace with actual ADC reading code
    # For example, using a library to read from an ADC
    # raw_value = analogRead(pin)
    raw_value = 512  # Example value, representing mid-scale
    return raw_value

def convert_to_celsius(raw_value):
    # Convert raw ADC value to voltage
    voltage = (raw_value / ADC_RESOLUTION) * ADC_REFERENCE_VOLTAGE
    
    # Convert voltage to temperature in Celsius
    # Placeholder conversion formula: Replace with actual sensor conversion
    celsius = (voltage - 0.5) * 100.0
    return celsius

def temp_monitor(temp1, temp2):
    average = (temp1 + temp2) / 2
    
    # When overheating
    if average > MAX_TEMP:
        enable_standby_mode()
    elif average > MAX_TEMP * 0.9:
        enable_low_power_run_mode()
    
    # When system has cooled down
    if average < MAX_TEMP * 0.8:
        # Check current mode and exit appropriately
        if is_in_standby_mode():
            exit_standby_mode()
        elif is_in_low_power_run_mode():
            exit_low_power_run_mode()

def enable_standby_mode():
    # Code to enable standby mode
    print("Entering standby mode")

def enable_low_power_run_mode():
    # Code to enable low power run mode
    print("Entering low power run mode")

def exit_standby_mode():
    # Code to exit standby mode
    print("Exiting standby mode")

def exit_low_power_run_mode():
    # Code to exit low power run mode
    print("Exiting low power run mode")

def is_in_standby_mode():
    # Placeholder function to check if in standby mode
    return False

def is_in_low_power_run_mode():
    # Placeholder function to check if in low power run mode
    return False

# Main function
def main():
    initialize_gpio()
    
    while True:
        # Obtain temperature values
        raw_temp1 = read_analog_value(SENSOR1_PIN)
        raw_temp2 = read_analog_value(SENSOR2_PIN)
        celsius_temp1 = convert_to_celsius(raw_temp1)
        celsius_temp2 = convert_to_celsius(raw_temp2)
        
        # Check if temperature within acceptable range
        temp_monitor(celsius_temp1, celsius_temp2)
        
        # Delay for a while to avoid excessive polling
        time.sleep(1)

if __name__ == "__main__":
    SENSOR1_PIN = 'P8_7'  # Example GPIO pin
    SENSOR2_PIN = 'P8_8'  # Example GPIO pin
    main()
